benheck/z80note/README.md

# z80note
Single board computer designed for Midwest Gaming Classic 2020 workshop
