benheck/z80note/schematics/z80note.png

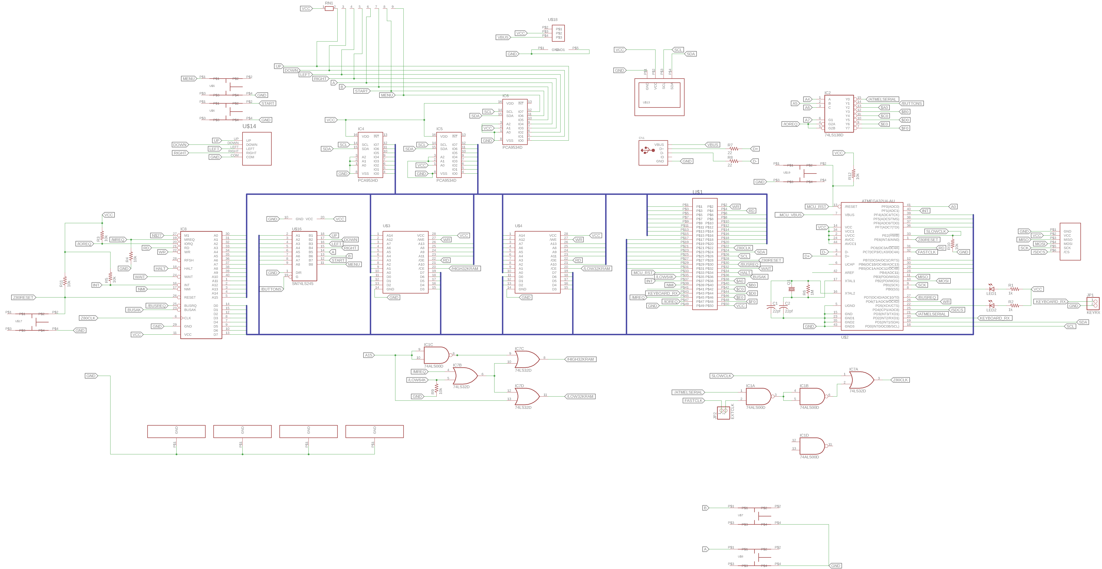
schematics/z80note.png
