benheck/z80note/code Arduino Leonardo/Bug List To Do.xlsx

ISSUE | DONE? | NOTES
Animate cursor on selection for option changes
Loading 0xFFFF files sometimes breaks
Add option to clear RAM
RAM viewer sometimes lags and shows wrong data
Add EEPROM settings save
Single step/stop not working
Load issues when scrolling past many files?
Scrolling files blanks out screen
Last record at bottom needs extra click to scroll?
Can we remove the XY position variables?
