benheck/z80note/(threads)

Thread 2 (2022-08-19):

Add gerber files

fixxer, 2022-08-19:
Hi Ben. Thank you for all your work, this project looks amazing. Is there a chance that you could also add gerber files to the repo for those poor folks who do not use eagle, like myself.

Best regards.
