benheck/z80note/(commit log)

2020-02-17 Added image of schematic
2020-03-08 Updated file structure
    [Command Codes.xlsx, SBC_rev 3.brd, SBC_rev 3.sch]
2020-03-09 More updates
    [SBC_rev 3.brd]
2020-03-09 Version sent to OSHpark
    [SBC_rev 3.brd]
2020-10-02 Added BOM
    [SBC_rev 3 BOM.csv]
2020-10-18 Reduced memory footprint
    [Bug List To Do.xlsx]
